Zantex3d/anti-bypass-meter/04_Value_Sheet.xlsx

Sheet: Meter values
PREPAID METER UNDER TEST - DESIGN VALUES
Blue = input you can change. Yellow = assumption to verify. Black = formula. All results come from these inputs.
Item | Value | Unit | Notes / source
A. Supply and transformer TR1 (voltage channel)
Mains voltage (RMS) | 230.0 | V | Nominal supply
Mains frequency | 50 | Hz
Source amplitude (peak) | 325.3 | V | Proteus ALTERNATOR amplitude is peak; you used 328 V
TR1 primary inductance Lp | 400 | H | Proteus TRAN-2P2S property
TR1 secondary inductance Ls | 1 | H | Proteus TRAN-2P2S property
TR1 turns ratio (Np:Ns) | 20.00 | :1 | Voltage ratio = sqrt(Lp/Ls)
TR1 coupling factor | 0.999 |  | Use 0.999, not 1: k = 1 can stop the SPICE solver
Secondary voltage (RMS) | 11.50 | V | Check with the AC voltmeter across the secondary
B. Divider and bias (A0)
R1 (series) | 68000 | ohm
R2 (A0 to VBIAS) | 10000 | ohm
R3 (+5 V to VBIAS) | 10000 | ohm
R4 (VBIAS to GND) | 10000 | ohm
Logic supply | 5 | V | ADC reference (AREF = 5 V)
C1 bias decoupling | 10 | uF | Must be 10 uF (1 nF does not hold the bias at 50 Hz)
VBIAS (DC) | 2.500 | V | Should be 2.5 V
Divider ratio (R1+R2)/R2 | 7.80
Peak voltage at A0 (AC part) | 2.085 | V | Swings VBIAS +/- this value
A0 minimum | 0.415 | V | Must stay above 0 V
A0 maximum | 4.585 | V | Must stay below 5 V
A0 range check | OK |  | Needs margin from the rails
C. ADC scaling used in the sketches
ADC steps | 1023 |  | 10-bit ADC
VOLT_PER_COUNT | 0.7625 | V/count | Copy into the sketch if you change any value above
Peak counts from 230 V | 426.6 | counts | Peak of the AC part of the A0 reading
Voltage resolution (RMS) | 0.762 | V/count | One ADC count in volts
D. Current channel ACS712 (A1)
ACS712 sensitivity (05B) | 0.185 | V/A | 185 mV/A for the 5 A part; 100 mV/A (20 A), 66 mV/A (30 A)
ACS712 zero-current output | 2.50 | V | Vcc / 2
AMP_PER_COUNT | 0.02642 | A/count | Copy into the sketch if the sensor changes
Noise floor in sketch | 0.03 | A | Currents below this are treated as zero
Maximum measurable current (RMS) | 9.56 | A | Before A1 clips
E. Load levels (lamps)
Lamp rating | 100 | W | Per lamp at the nominal voltage
Lamp resistance (hot) | 529.0 | ohm | Set the Proteus lamp to about this resistance / 230 V rating
Lamps on | Power (W) | Current (A) | A1 peak swing (V) / peak counts
1 | 100 | 0.435 | 0.114 V / 23 counts
2 | 200 | 0.870 | 0.228 V / 47 counts
3 | 300 | 1.304 | 0.341 V / 70 counts
F. Relay driver
Relay coil voltage | 12 | V
Relay coil resistance | 400 | ohm | ASSUMPTION: read it from the Proteus RELAY / datasheet
Coil current | 30.0 | mA
BC547 minimum hFE | 110 |  | Datasheet-level assumption
Forced beta (design) | 10 |  | Rule of thumb for saturation
Required base current | 3.00 | mA
R5 maximum for saturation | 1433.333333 | ohm | Conservative limit (forced beta 10). The chosen R5 only needs a forced beta well below hFE
R5 chosen | 2200 | ohm
Actual base current | 1.95 | mA
Actual forced beta | 15.3 |  | Below hFE min means Q1 saturates
Arduino pin current check | OK (<20 mA) |  | Mega pin limit about 20 mA continuous
Saturation check | OK
R6 pull-down | 100000 | ohm | Keeps the relay off while the Mega boots
G. Logic link to the verifier
R8 | 1000 | ohm
R9 | 2000 | ohm
ESP32 RX voltage | 3.33 | V | 3.3 V logic: should be about 3.3 V
Voltage-level check | OK |  | Proteus Mega-to-Mega link does not need the divider
H. Billing
Tariff | 100 | N/kWh | Demonstration value
Initial balance | 1000 | N
Low-balance warning | 100 | N
TIME_ACCEL (demo) | 600 | x | 1 simulated second billed as this many seconds. Use 1 for true time.
Lamps on | Cost rate (N/h, real) | Cost rate (N per sim s) | Time to empty at initial balance (sim s)
1 | 10.00 | 1.667 | 600
2 | 20.00 | 3.333 | 300
3 | 30.00 | 5.000 | 200

Sheet: Detection
EXTERNAL VERIFIER - DETECTION SETTINGS AND EXAMPLE
Item | Value | Unit | Notes
A. Settings (match the firmware constants)
Window length | 60 | s | WINDOW_S: meter-time seconds per comparison
Tolerance | 3 | % | TOL_PCT: PLACEHOLDER. Set from normal-run data (see sheet 'Tolerance').
Persistence | 3 | windows | PERSIST_N: windows in a row above tolerance before ALERT
Minimum reference energy per window | 0.5 | Wh | MIN_REF_WH: smaller windows are skipped
Meter TIME_ACCEL | 600 | x | Link: must equal the verifier's frame value
Minimum power for a valid window | 0.05 | W | Below this the window is skipped (accounts for TIME_ACCEL)
Time to ALERT after onset | 180 | s | At least this long (meter time) after under-registration starts
B. Worked example (illustrative, not a result)
Reference energy in window | 3.333 | Wh | 200 W for 60 s at TIME_ACCEL 1
Meter energy in window | 3.000 | Wh | Meter registering 10% less
Signed error e% | -9.99 | % | e = (E_meter - E_ref) / E_ref x 100
Under-registration U% | 9.99 | % | U = (E_ref - E_meter) / E_ref x 100 (positive = under-registration)
Window violates tolerance? | YES
Status after PERSIST_N such windows | ALERT

Sheet: Tolerance
TOLERANCE FROM NORMAL RUNS
Paste U% of NORMAL windows (label 0) in column A from row 5. Results update automatically.
Column A holds EXAMPLE values only. Replace them with your measured normal-window U%.
U% (normal) | Statistic | Value | Meaning
-0.07 | Count | 8 | Number of windows
0.07 | Mean U% | 0.022 | Systematic offset of the meter vs reference
0.10 | Std dev U% | 0.076 | Spread of normal windows
-0.08 | k (sigma multiple) | 3.0 | 3 sigma is a common starting point
0.05 | Suggested tolerance | 0.25 | mean + k x sigma: use as TOL_PCT, then test false alarms
0.12 | Maximum observed U% | 0.120 | Sanity check against the suggestion
-0.03
0.02

Sheet: Components
COMPONENT LIST
Ref | Part | Value | Proteus part / setting | Qty | Notes
AC1 | AC source | 230 V 50 Hz | ALTERNATOR, amplitude 328 V | 1 | Peak value; about 232 V RMS
RL1 | Relay | 12 V coil | RELAY (12 V) | 1 | Coil in driver, contacts in mains path
ACS1 | Current sensor | ACS712-05B | ACS712ELCTR-05B-T (library) | 1 | Meter sensor
ACS2 | Current sensor | ACS712-05B | ACS712ELCTR-05B-T (library) | 1 | Verifier sensor, in series with ACS1
SW1-SW3 | Lamp switches | SPST | SWITCH (clickable) | 3 | Click during simulation
L1-L3 | Lamps | 100 W | LAMP, Operating Voltage 230 V | 3 | NOT 12 V
TR1 | Transformer | 20:1 | TRAN-2P2S 400 H / 1 H, k 0.999 | 1 | Meter voltage sensing
TR2 | Transformer | 20:1 | TRAN-2P2S 400 H / 1 H, k 0.999 | 1 | Verifier voltage sensing
R1 | Resistor | 68 kohm | RES | 1
R2 | Resistor | 10 kohm | RES | 1
R3 | Resistor | 10 kohm | RES | 1
R4 | Resistor | 10 kohm | RES | 1
C1 | Capacitor | 10 uF | CAP-ELEC | 1 | Bias decoupling
C3 | Capacitor | 1 nF | CAP | 1 | ACS1 FILTER
R5 | Resistor | 2.2 kohm | RES | 1 | Base resistor
R6 | Resistor | 100 kohm | RES | 1 | Base pull-down
R7 | Resistor | 1 Mohm | RES | 1 | NEUTRAL to GND, simulation reference
Q1 | Transistor | BC547 | BC547 | 1
D1 | Diode | 1N4007 | 1N4007 | 1 | Across relay coil
B1 | Battery | 12 V | BATTERY | 1 | Relay coil supply
B2/B3 | Battery | 5 V | BATTERY | 2 | Logic / LCD supply (ground common)
R8 | Resistor | 1 kohm | RES | 1 | Hardware link divider
R9 | Resistor | 2 kohm | RES | 1 | Hardware link divider
U1 | Arduino Mega 2560 |  | ARDUINO MEGA 2560 + 01_Meter_Mega2560.hex | 1 | Meter under test
LCD1 | LCD | 16x2 | LM044L | 1
RV1 | Potentiometer | 10 kohm | POT-HG | 1 | Contrast
KP1 | Keypad | 4x3 | KEYPAD-PHONE | 1
VT1 | Virtual terminal | 115200 | VIRTUAL TERMINAL | 1 | Meter log
U3 | Arduino Mega 2560 |  | ARDUINO MEGA 2560 + 04_Verifier_Proteus_Mega.hex | 1 | Verifier stand-in
LCD2 | LCD | 16x2 | LM044L | 1
RV2 | Potentiometer | 10 kohm | POT-HG | 1
R10 | Resistor | 68 kohm | RES | 1 | TR2 divider
R11-R13 | Resistor | 10 kohm | RES | 3 | TR2 divider and bias
C5 | Capacitor | 10 uF | CAP-ELEC | 1
C6 | Capacitor | 1 nF | CAP | 1 | ACS2 FILTER
R14-R16 | Resistor | 330 ohm | RES | 3 | LED resistors
LED2-LED4 | LED | green/yellow/red | LED-GREEN / YELLOW / RED | 3 | NORMAL / SUSPECT / ALERT
VT2 | Virtual terminal | 115200 | VIRTUAL TERMINAL | 1 | Verifier log and commands
U2 (HW) | ATM90E26 module |  | No Proteus model | 1 | Hardware stage, Sheet 2
U4 (HW) | ESP32 DevKit |  | No official Proteus model | 1 | Hardware stage, Sheet 2
VT, CT (HW) | Voltage sensor, CT |  | Hardware stage | 2 | Ratings per module

Sheet: Pin map
PIN MAP
Board | Pin | Net | Connects to
Meter Mega U1 | A0 | VSENSE | R1/R2 node from TR1 divider
Meter Mega U1 | A1 | ISENSE | ACS1 VIOUT
Meter Mega U1 | D7 | RELAY_DRV | R5 to Q1 base
Meter Mega U1 | D18 (TX1) | TX1 | Verifier D19 (Proteus) / R8-R9 to ESP32 GPIO16
Meter Mega U1 | D1 (TX0) | TX0 | VT1
Meter Mega U1 | D22-D27 | LCD_RS, LCD_E, LCD_D4-D7 | LCD1 RS, E, D4-D7
Meter Mega U1 | D30-D33 | ROW_A-ROW_D | KP1 rows A-D
Meter Mega U1 | D34-D36 | COL_1-COL_3 | KP1 columns 1-3
Verifier Mega U3 | A0 | VSENSE2 | TR2 divider
Verifier Mega U3 | A1 | ISENSE2 | ACS2 VIOUT
Verifier Mega U3 | D19 (RX1) | FROM_METER | Meter D18 (TX1)
Verifier Mega U3 | D1 / D0 | TX0 / RX0 | VT2 RXD / TXD
Verifier Mega U3 | D22-D27 | LCD_RS ... LCD_D7 | LCD2
Verifier Mega U3 | D8, D9, D10 | LED_G, LED_Y, LED_R | R14-R16 to LED2-LED4
ESP32 (hardware) | GPIO5 | CS | ATM90E26 CS
ESP32 (hardware) | GPIO18 | SCK | ATM90E26 SCK
ESP32 (hardware) | GPIO23 | MOSI | ATM90E26 SDI
ESP32 (hardware) | GPIO19 | MISO | ATM90E26 SDO
ESP32 (hardware) | GPIO16 (RX2) | ESP_RX | R8/R9 divider from meter TX1
ESP32 (hardware) | GPIO25/26/27 | LED_G/Y/R | 330 ohm to LEDs

Sheet: Test log
TEST LOG (fill in as you run each test)
Test | Lamps | Vrms (LCD) | Irms (LCD) | P (LCD) W | E_meter Wh | E_ref Wh | Error % (meter vs ref) | U% | Detected? | Notes
EXAMPLE | 3 | 229.6 | 1.3 | 299.5 | 16.6 | 16.65 | -0.30 | 0.30 | no | Illustrative values only, replace
