Zantex3d/anti-bypass-meter/(list of files, drawings)

Other design files:
01_Meter_Mega2560/Prepaid_Meter_Integrity_Verification_meter_1.pdsprj
01_Meter_Mega2560/Project Backups/Prepaid_Meter_Integrity_Verification_meter_1 [20261015, 22-54-31].pdsprj
01_Meter_Mega2560/Project Backups/Prepaid_Meter_Integrity_Verification_meter_1 [20261015, 22-54-32].pdsprj
